GiesbrechtElectronics/GEQ1/GEQ1_AusfB_R3/BOM/GEQ1_AusfB_R3.xlsx

Sheet: Project
Capacitors
Order Qty. | Reference | Value | LibPart | Footprint | Mouser # | Mfr. # | Manufacturer | Customer # | Description | RoHS | Lifecycle | Order Qty. | Price (USD) | Ext.: (USD)
6 | C3, C6, C7, C8, C17, C18 | 100nF | device:C | Capacitors_SMD:C_0805 | 710-885012207098 | 885012207098 | Wurth Elektronik |  | Multilayer Ceramic Capacitors MLCC - SMD/SMT WCAP-CSGP 0.1uF 0805 10% 50V MLCC | RoHS Compliant |  | 6 | $0.10 | $0.60
6 | C21, C22, C25, C26, C27, C28 | 100pF | device:C | Capacitors_SMD:C_0805 | 710-885012007082 | 885012007082 | Wurth Elektronik |  | Multilayer Ceramic Capacitors MLCC - SMD/SMT WCAP-CSGP 100V 100pF 0805 5% | RoHS Compliant | New At Mouser | 6 | $0.10 | $0.60
4 | C14, C16, C19, C20 | 1.5uF | device:C | Capacitors_SMD:C_0805 | 810-C2012JB1E155K08C | C2012JB1E155K085AC | TDK |  | Multilayer Ceramic Capacitors MLCC - SMD/SMT 0805 25V 1.5uF JB 10% T: 0.85mm | RoHS Compliant |  | 4 | $0.27 | $1.08
2 | C1, C2 | 7.5nF | device:C | Capacitors_SMD:C_0805 | 81-GRM2195C1H752JA1D | GRM2195C1H752JA01D | Murata |  | Multilayer Ceramic Capacitors MLCC - SMD/SMT 0.0075uF 50Volts C0G 0.05 | RoHS Compliant |  | 2 | $0.34 | $0.68
2 | C4, C5 | 560pF | device:C | Capacitors_SMD:C_0805 | 77-VJ0805A561JXAAC | VJ0805A561JXAAC | Vishay |  | Multilayer Ceramic Capacitors MLCC - SMD/SMT 560pF 50volts C0G 5% | RoHS Compliant |  | 2 | $0.13 | $0.26
2 | C9, C11 | 22nF | device:C | Capacitors_SMD:C_0805 | 80-C0805C223K2RECAUT | C0805C223K2RECAUTO | KEMET |  | Multilayer Ceramic Capacitors MLCC - SMD/SMT 200V .022uF X7R 0805 10% AEC-Q200 | RoHS Compliant | New Product | 2 | $0.27 | $0.54
2 | C10, C12 | 220nF | device:C | Capacitors_SMD:C_0805 | 710-885012207074 | 885012207074 | Wurth Elektronik |  | Multilayer Ceramic Capacitors MLCC - SMD/SMT WCAP-CSGP 0.22uF 0805 10% 25V MLCC | RoHS Compliant |  | 2 | $0.11 | $0.22
2 | C13, C15 | 220uF | device:CP | Capacitors_SMD:CP_Elec_8x10 | 647-UWT1V221MNL1S | UWT1V221MNL1GS | Nichicon |  | Aluminum Electrolytic Capacitors - SMD 35volts 220uF 8x10 20% | RoHS Compliant |  | 2 | $0.44 | $0.88
2 | C23, C24 | 10nF | device:C | Capacitors_SMD:C_0805 | 710-885012207092 | 885012207092 | Wurth Elektronik |  | Multilayer Ceramic Capacitors MLCC - SMD/SMT WCAP-CSGP 0.01uF 0805 10% 50V MLCC | RoHS Compliant |  | 2 | $0.10 | $0.20
Resistors
Order Qty. | Reference | Value | LibPart | Footprint | Mouser # | Mfr. # | Manufacturer | Customer # | Description | RoHS | Lifecycle | Order Qty. | Price (USD) | Ext.: (USD)
12 | R3, R5, R10, R12, R14, R16, R21, R22, R34, R35, R36, R37 | 100K | device:R | Resistors_SMD:R_0805 | 652-CR0805FX-1003ELF | CR0805-FX-1003ELF | Bourns |  | Thick Film Resistors - SMD 100K 1% | RoHS Compliant By Exemption |  | 12 | $0.01 | $0.18
5 | R1, R11, R27, R32, R33 | 10K | device:R | Resistors_SMD:R_0805 | 652-CR0805FX-1002ELF | CR0805-FX-1002ELF | Bourns |  | Thick Film Resistors - SMD 10K 1% | RoHS Compliant By Exemption |  | 5 | $0.10 | $0.50
4 | R2, R4, R8, R9 | 49.9R | device:R | Resistors_SMD:R_0805 | 652-CR0805FX-49R9ELF | CR0805-FX-49R9ELF | Bourns |  | Thick Film Resistors - SMD 49.9ohm 1% | RoHS Compliant By Exemption |  | 4 | $0.10 | $0.40
4 | R13, R15, R19, R20 | 1.24K | device:R | Resistors_SMD:R_0805 | 603-AC0805FR-071K24L | AC0805FR-071K24L | Yageo |  | Thick Film Resistors - SMD AEC-Q200 | RoHS Compliant |  | 4 | $0.16 | $0.64
4 | R23, R24, R25, R26 | 249R | device:R | Resistors_SMD:R_0805 | 652-CR0805FX-2490ELF | CR0805-FX-2490ELF | Bourns |  | Thick Film Resistors - SMD 249ohm 1% | RoHS Compliant By Exemption |  | 4 | $0.10 | $0.40
3 | R6, R17, R18 | 49.9K | device:R | Resistors_SMD:R_0805 | 71-RCG080549K9FKEA | RCG080549K9FKEA | Vishay |  | Thick Film Resistors - SMD .125watt 49.9kohms 1% 0805 100ppm | RoHS Compliant |  | 3 | $0.10 | $0.30
3 | RV1, RV2, RV3 | 50K | device:POT_Dual_Separate | AlphaFootprints:POT_2GANG_RK12L | 688-RK12L123000E | RK12L123000E | ALPS |  | Potentiometers 12MM V/ADJ | RoHS Compliant |  | 3 | $0.92 | $2.76
2 | R28, R29 | 1K | device:R | Resistors_SMD:R_0805 | 652-CR0805FX-1001ELF | CR0805-FX-1001ELF | Bourns |  | Thick Film Resistors - SMD 1K 1% | RoHS Compliant By Exemption |  | 2 | $0.10 | $0.20
2 | R30, R31 | 2.49K | device:R | Resistors_SMD:R_0805 | 652-CR0805FX-2491ELF | CR0805-FX-2491ELF | Bourns |  | Thick Film Resistors - SMD 2.49K 1% | RoHS Compliant By Exemption |  | 2 | $0.10 | $0.20
1 | R7 | 2R | device:R | Resistors_SMD:R_0805 | 603-RC0805FR-072RL | RC0805FR-072RL | Yageo |  | Thick Film Resistors - SMD 2 OHM 1% | RoHS Compliant |  | 1 | $0.10 | $0.10
1 | RV4 | 20K | device:POT_Dual_Separate | AlphaFootprints:POT_2GANG_RK12L | 688-RK12L12C0A0A | RK12L12C0A0A | ALPS |  | Potentiometers 12MM V/ADJ | RoHS Compliant |  | 1 | $0.70 | $0.70
Transistors
Order Qty. | Reference | Value | LibPart | Footprint | Mouser # | Mfr. # | Manufacturer | Customer # | Description | RoHS | Lifecycle | Order Qty. | Price (USD) | Ext.: (USD)
2 | Q2, Q3 | DMP3098LQ-7 | device:Q_PMOS_GSD | TO_SOT_Packages_SMD:SOT-23 | 621-DMP3098LQ-7 | DMP3098LQ-7 | Diodes Incorporated |  | MOSFET MOSFETBVDSS: 25V-30V | RoHS Compliant | New At Mouser | 2 | $0.34 | $0.68
1 | Q1 | BC856 | device:Q_PNP_BEC | TO_SOT_Packages_SMD:SOT-23_Handsoldering | 863-BC856BLT1G | BC856BLT1G | ON Semiconductor |  | Bipolar Transistors - BJT 100mA 80V PNP | RoHS Compliant |  | 1 | $0.13 | $0.13
Electromechanical
Order Qty. | Reference | Value | LibPart | Footprint | Mouser # | Mfr. # | Manufacturer | Customer # | Description | RoHS | Lifecycle | Order Qty. | Price (USD) | Ext.: (USD)
2 | M1, M2 | SJ-43515TS | AlphaComponents:AUDIO-JACK-TRRS | AlphaFootprints:TRRS_SJ-43515TS | 490-SJ-43515TS | SJ-43515TS | CUI Inc. |  | Phone Connectors audio jack, 3.5 mm, rt, 4 conductor, through hole, 1 switch | RoHS Compliant |  | 2 | $1.04 | $2.08
1 | SW1 | 2M1-SP1-T1-B1-M2QE | GEQ1_AusfB_R3-cache:SW_SPST-RESCUE-GEQ1_AusfB_R1 | AlphaFootprints:2M1-SP1-TnBnM2 | 691-2M1-SP1-T1B1M2QE | 2M1-SP1-T1-B1-M2QE | Carling Technologies |  | Toggle Switches Toggle PC MNT ON -NONE -ON | RoHS Compliant |  | 1 | $2.32 | $2.32
1 | J1 | PJ-102A | conn:Barrel_Jack | AlphaFootprints:PJ_102A | 490-PJ-102A | PJ-102A | CUI Inc. | GP-DC PJ | DC Power Connectors Power Jacks | RoHS Compliant |  | 1 | $0.64 | $0.64
1 | BT1 | 9V | device:Battery | AlphaFootprints:2_Pin_Header | 534-81-8TB | 81-8 | Keystone Electronics |  | 9V Battery Snaps & Contacts SHIELDED 9 VOLT "T" Strap 8.0" L | RoHS Compliant |  | 1 | $0.49 | $0.49
1 | - | Knob-Large | - | - | 45KN013-GRX | 45KN013-GRX | Eagle Plastic Devices |  | Knobs & Dials BLACK 0.94"DX0.59"H | RoHS Compliant By Exemption |  | 1 | $1.14 | $1.14
Semis (Other)
Order Qty. | Reference | Value | LibPart | Footprint | Mouser # | Mfr. # | Manufacturer | Customer # | Description | RoHS | Lifecycle | Order Qty. | Price (USD) | Ext.: (USD)
6 | U1, U2, U3, U4, U5, U6 | LM833 | linear:LM7332 | AlphaFootprints:SOIC-8_Pin1Line | 511-LM833DT | LM833DT | STMicroelectronics |  | Audio Amplifiers Dual Low Noise | RoHS Compliant |  | 6 | $0.53 | $3.18
1 | D1 | BLUE | device:LED | AlphaFootprints:LED_1206_REV | 859-LTST-C230TBKT | LTST-C230TBKT | Lite-On |  | Standard LEDs - SMD Blue Clear 470nm | RoHS Compliant |  | 1 | $0.36 | $0.36
Inductors
Order Qty. | Reference | Value | LibPart | Footprint | Mouser # | Mfr. # | Manufacturer | Customer # | Description | RoHS | Lifecycle | Order Qty. | Price (USD) | Ext.: (USD)
2 | L1, L2 | MPZ2012S102JTD25 | device:Ferrite_Bead | Inductors_SMD:L_0805 | 810-MPZ2012S102JTD25 | MPZ2012S102JTD25 | TDK |  | Ferrite Beads 0805 1.5A 25% 0.15ohms AEC-Q200 | RoHS Compliant | New Product | 2 | $0.13 | $0.26

Sheet: Project (2)
Capacitors
Order Qty. | Reference | Value | LibPart | Footprint | Mouser # | Mfr. # | Manufacturer | Customer # | Description | RoHS | Lifecycle | Order Qty. | Price (USD) | Ext.: (USD)
6 | C3, C6, C7, C8, C17, C18 | 100nF | device:C | Capacitors_SMD:C_0805 | 710-885012207098 | 885012207098 | Wurth Elektronik |  | Multilayer Ceramic Capacitors MLCC - SMD/SMT WCAP-CSGP 0.1uF 0805 10% 50V MLCC | RoHS Compliant |  | 6 | $0.10 | $0.60
6 | C21, C22, C25, C26, C27, C28 | 100pF | device:C | Capacitors_SMD:C_0805 | 710-885012007082 | 885012007082 | Wurth Elektronik |  | Multilayer Ceramic Capacitors MLCC - SMD/SMT WCAP-CSGP 100V 100pF 0805 5% | RoHS Compliant | New At Mouser | 6 | $0.10 | $0.60
4 | C14, C16, C19, C20 | 1.5uF | device:C | Capacitors_SMD:C_0805 | 810-C2012JB1E155K08C | C2012JB1E155K085AC | TDK |  | Multilayer Ceramic Capacitors MLCC - SMD/SMT 0805 25V 1.5uF JB 10% T: 0.85mm | RoHS Compliant |  | 4 | $0.27 | $1.08
2 | C1, C2 | 7.5nF | device:C | Capacitors_SMD:C_0805 | 81-GRM2195C1H752JA1D | GRM2195C1H752JA01D | Murata |  | Multilayer Ceramic Capacitors MLCC - SMD/SMT 0.0075uF 50Volts C0G 0.05 | RoHS Compliant |  | 2 | $0.34 | $0.68
2 | C4, C5 | 560pF | device:C | Capacitors_SMD:C_0805 | 77-VJ0805A561JXAAC | VJ0805A561JXAAC | Vishay |  | Multilayer Ceramic Capacitors MLCC - SMD/SMT 560pF 50volts C0G 5% | RoHS Compliant |  | 2 | $0.13 | $0.26
2 | C9, C11 | 22nF | device:C | Capacitors_SMD:C_0805 | 80-C0805C223K2RECAUT | C0805C223K2RECAUTO | KEMET |  | Multilayer Ceramic Capacitors MLCC - SMD/SMT 200V .022uF X7R 0805 10% AEC-Q200 | RoHS Compliant | New Product | 2 | $0.27 | $0.54
2 | C10, C12 | 220nF | device:C | Capacitors_SMD:C_0805 | 710-885012207074 | 885012207074 | Wurth Elektronik |  | Multilayer Ceramic Capacitors MLCC - SMD/SMT WCAP-CSGP 0.22uF 0805 10% 25V MLCC | RoHS Compliant |  | 2 | $0.11 | $0.22
2 | C13, C15 | 220uF | device:CP | Capacitors_SMD:CP_Elec_8x10 | 647-UWT1V221MNL1S | UWT1V221MNL1GS | Nichicon |  | Aluminum Electrolytic Capacitors - SMD 35volts 220uF 8x10 20% | RoHS Compliant |  | 2 | $0.44 | $0.88
2 | C23, C24 | 10nF | device:C | Capacitors_SMD:C_0805 | 710-885012207092 | 885012207092 | Wurth Elektronik |  | Multilayer Ceramic Capacitors MLCC - SMD/SMT WCAP-CSGP 0.01uF 0805 10% 50V MLCC | RoHS Compliant |  | 2 | $0.10 | $0.20
Resistors
Order Qty. | Reference | Value | LibPart | Footprint | Mouser # | Mfr. # | Manufacturer | Customer # | Description | RoHS | Lifecycle | Order Qty. | Price (USD) | Ext.: (USD)
12 | R3, R5, R10, R12, R14, R16, R21, R22, R34, R35, R36, R37 | 100K | device:R | Resistors_SMD:R_0805 | 652-CR0805FX-1003ELF | CR0805-FX-1003ELF | Bourns |  | Thick Film Resistors - SMD 100K 1% | RoHS Compliant By Exemption |  | 12 | $0.01 | $0.18
5 | R1, R11, R27, R32, R33 | 10K | device:R | Resistors_SMD:R_0805 | 652-CR0805FX-1002ELF | CR0805-FX-1002ELF | Bourns |  | Thick Film Resistors - SMD 10K 1% | RoHS Compliant By Exemption |  | 5 | $0.10 | $0.50
4 | R2, R4, R8, R9 | 49.9R | device:R | Resistors_SMD:R_0805 | 652-CR0805FX-49R9ELF | CR0805-FX-49R9ELF | Bourns |  | Thick Film Resistors - SMD 49.9ohm 1% | RoHS Compliant By Exemption |  | 4 | $0.10 | $0.40
4 | R13, R15, R19, R20 | 1.24K | device:R | Resistors_SMD:R_0805 | 603-AC0805FR-071K24L | AC0805FR-071K24L | Yageo |  | Thick Film Resistors - SMD AEC-Q200 | RoHS Compliant |  | 4 | $0.16 | $0.64
4 | R23, R24, R25, R26 | 249R | device:R | Resistors_SMD:R_0805 | 652-CR0805FX-2490ELF | CR0805-FX-2490ELF | Bourns |  | Thick Film Resistors - SMD 249ohm 1% | RoHS Compliant By Exemption |  | 4 | $0.10 | $0.40
3 | R6, R17, R18 | 49.9K | device:R | Resistors_SMD:R_0805 | 71-RCG080549K9FKEA | RCG080549K9FKEA | Vishay |  | Thick Film Resistors - SMD .125watt 49.9kohms 1% 0805 100ppm | RoHS Compliant |  | 3 | $0.10 | $0.30
3 | RV1, RV2, RV3 | 50K | device:POT_Dual_Separate | AlphaFootprints:POT_2GANG_RK12L | 688-RK12L123000E | RK12L123000E | ALPS |  | Potentiometers 12MM V/ADJ | RoHS Compliant |  | 3 | $0.92 | $2.76
2 | R28, R29 | 1K | device:R | Resistors_SMD:R_0805 | 652-CR0805FX-1001ELF | CR0805-FX-1001ELF | Bourns |  | Thick Film Resistors - SMD 1K 1% | RoHS Compliant By Exemption |  | 2 | $0.10 | $0.20
2 | R30, R31 | 2.49K | device:R | Resistors_SMD:R_0805 | 652-CR0805FX-2491ELF | CR0805-FX-2491ELF | Bourns |  | Thick Film Resistors - SMD 2.49K 1% | RoHS Compliant By Exemption |  | 2 | $0.10 | $0.20
1 | R7 | 2R | device:R | Resistors_SMD:R_0805 | 603-RC0805FR-072RL | RC0805FR-072RL | Yageo |  | Thick Film Resistors - SMD 2 OHM 1% | RoHS Compliant |  | 1 | $0.10 | $0.10
1 | RV4 | 20K | device:POT_Dual_Separate | AlphaFootprints:POT_2GANG_RK12L | 688-RK12L12C0A0A | RK12L12C0A0A | ALPS |  | Potentiometers 12MM V/ADJ | RoHS Compliant |  | 1 | $0.70 | $0.70
Transistors
Order Qty. | Reference | Value | LibPart | Footprint | Mouser # | Mfr. # | Manufacturer | Customer # | Description | RoHS | Lifecycle | Order Qty. | Price (USD) | Ext.: (USD)
2 | Q2, Q3 | DMP3098LQ-7 | device:Q_PMOS_GSD | TO_SOT_Packages_SMD:SOT-23 | 621-DMP3098LQ-7 | DMP3098LQ-7 | Diodes Incorporated |  | MOSFET MOSFETBVDSS: 25V-30V | RoHS Compliant | New At Mouser | 2 | $0.34 | $0.68
1 | Q1 | BC856 | device:Q_PNP_BEC | TO_SOT_Packages_SMD:SOT-23_Handsoldering | 863-BC856BLT1G | BC856BLT1G | ON Semiconductor |  | Bipolar Transistors - BJT 100mA 80V PNP | RoHS Compliant |  | 1 | $0.13 | $0.13
Electromechanical
Order Qty. | Reference | Value | LibPart | Footprint | Mouser # | Mfr. # | Manufacturer | Customer # | Description | RoHS | Lifecycle | Order Qty. | Price (USD) | Ext.: (USD)
2 | M1, M2 | SJ-43515TS | AlphaComponents:AUDIO-JACK-TRRS | AlphaFootprints:TRRS_SJ-43515TS | 490-SJ-43515TS | SJ-43515TS | CUI Inc. |  | Phone Connectors audio jack, 3.5 mm, rt, 4 conductor, through hole, 1 switch | RoHS Compliant |  | 2 | $1.04 | $2.08
1 | SW1 | 2M1-SP1-T1-B1-M2QE | GEQ1_AusfB_R3-cache:SW_SPST-RESCUE-GEQ1_AusfB_R1 | AlphaFootprints:2M1-SP1-TnBnM2 | 691-2M1-SP1-T1B1M2QE | 2M1-SP1-T1-B1-M2QE | Carling Technologies |  | Toggle Switches Toggle PC MNT ON -NONE -ON | RoHS Compliant |  | 1 | $2.32 | $2.32
1 | J1 | PJ-102A | conn:Barrel_Jack | AlphaFootprints:PJ_102A | 490-PJ-102A | PJ-102A | CUI Inc. | GP-DC PJ | DC Power Connectors Power Jacks | RoHS Compliant |  | 1 | $0.64 | $0.64
1 | BT1 | 9V | device:Battery | AlphaFootprints:2_Pin_Header | 534-81-8TB | 81-8 | Keystone Electronics |  | 9V Battery Snaps & Contacts SHIELDED 9 VOLT "T" Strap 8.0" L | RoHS Compliant |  | 1 | $0.49 | $0.49
1 | - | Knob-Large | - | - | 45KN013-GRX | 45KN013-GRX | Eagle Plastic Devices |  | Knobs & Dials BLACK 0.94"DX0.59"H | RoHS Compliant By Exemption |  | 1 | $1.14 | $1.14
Semis (Other)
Order Qty. | Reference | Value | LibPart | Footprint | Mouser # | Mfr. # | Manufacturer | Customer # | Description | RoHS | Lifecycle | Order Qty. | Price (USD) | Ext.: (USD)
6 | U1, U2, U3, U4, U5, U6 | LM833 | linear:LM7332 | AlphaFootprints:SOIC-8_Pin1Line | 511-LM833DT | LM833DT | STMicroelectronics |  | Audio Amplifiers Dual Low Noise | RoHS Compliant |  | 6 | $0.53 | $3.18
1 | D1 | BLUE | device:LED | AlphaFootprints:LED_1206_REV | 859-LTST-C230TBKT | LTST-C230TBKT | Lite-On |  | Standard LEDs - SMD Blue Clear 470nm | RoHS Compliant |  | 1 | $0.36 | $0.36
Inductors
Order Qty. | Reference | Value | LibPart | Footprint | Mouser # | Mfr. # | Manufacturer | Customer # | Description | RoHS | Lifecycle | Order Qty. | Price (USD) | Ext.: (USD)
2 | L1, L2 | MPZ2012S102JTD25 | device:Ferrite_Bead | Inductors_SMD:L_0805 | 810-MPZ2012S102JTD25 | MPZ2012S102JTD25 | TDK |  | Ferrite Beads 0805 1.5A 25% 0.15ohms AEC-Q200 | RoHS Compliant | New Product | 2 | $0.13 | $0.26
