GiesbrechtElectronics/GEQ1/GEQ1_AusfB_R3/Products/GEQ1_AusfB_R3.pdf

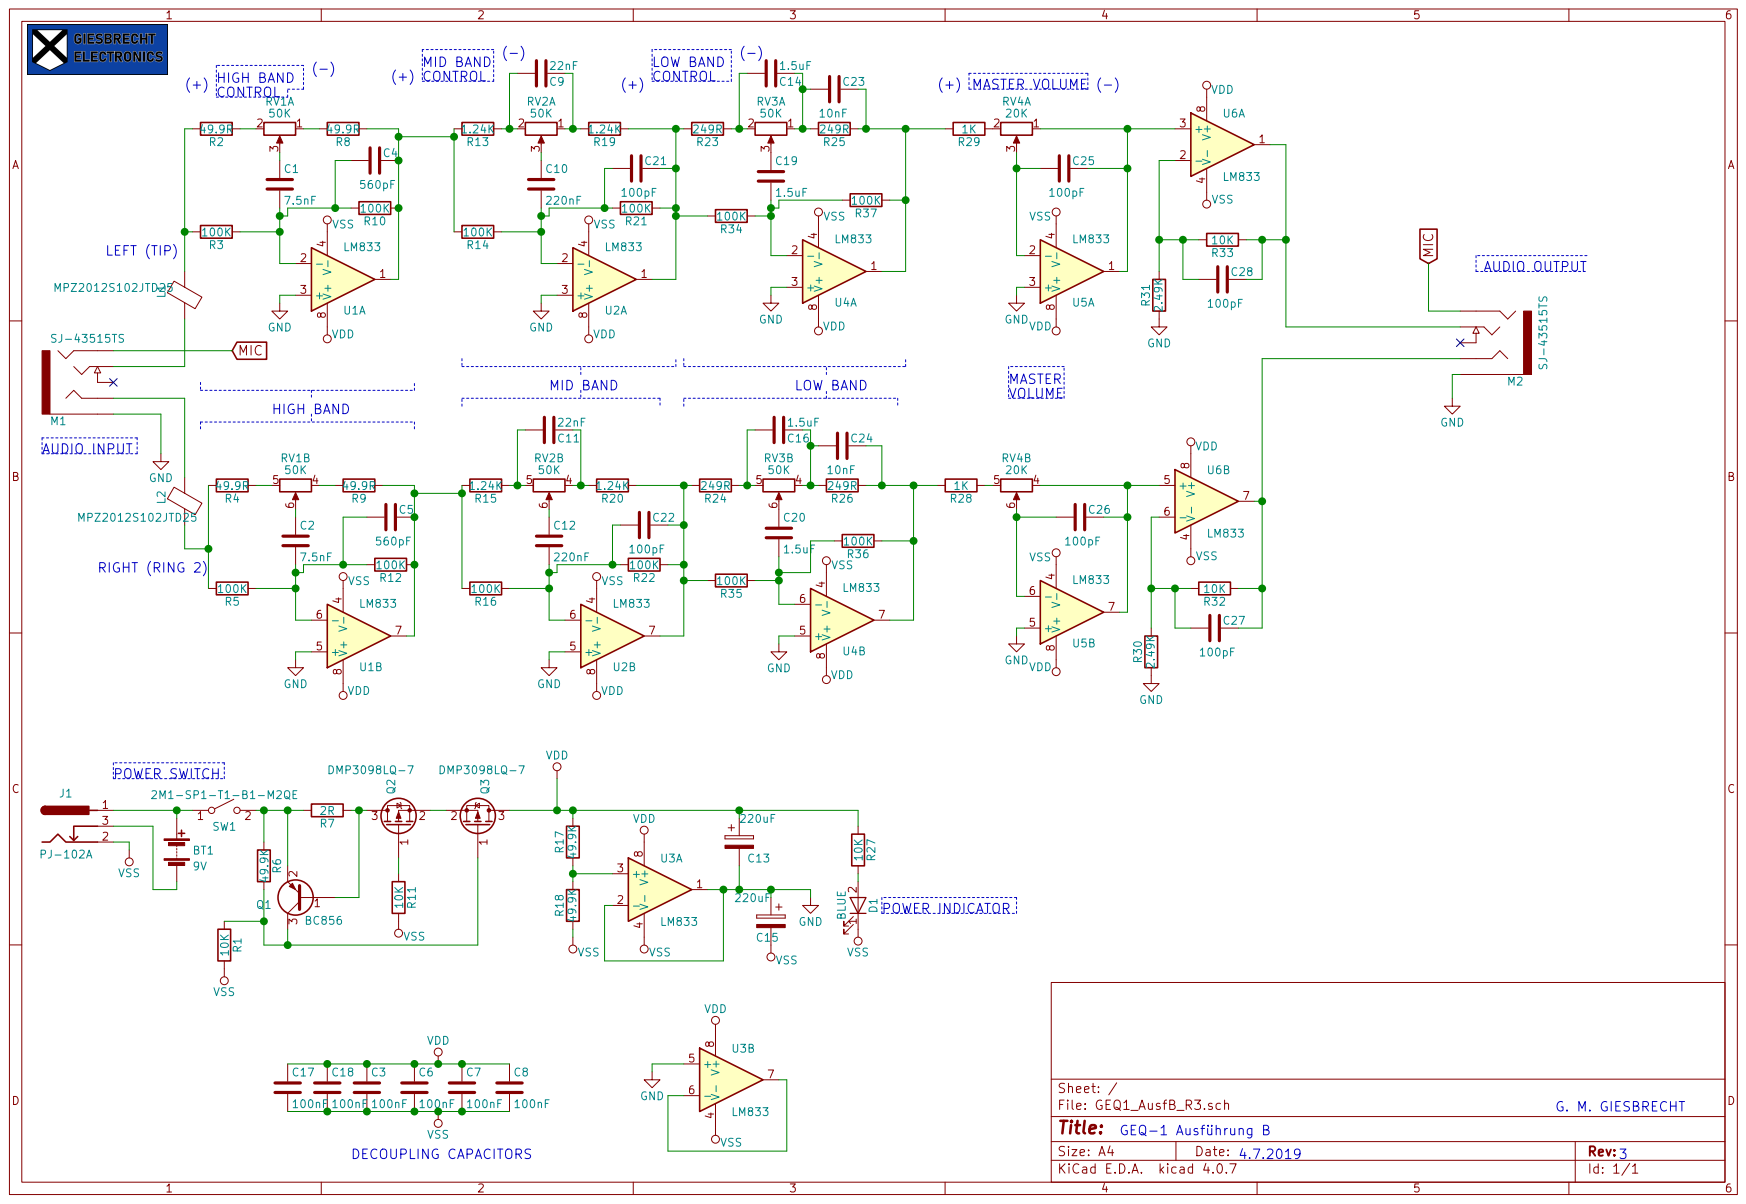
[picture p1: page 1]
