GiesbrechtElectronics/GEQ1/GEQ1_AusfB_R3/GEQ1_AusfB_R3.kicad_pcb

## KiCad design GEQ1_AusfB_R3/GEQ1_AusfB_R3.kicad_pcb (2019-09-10)

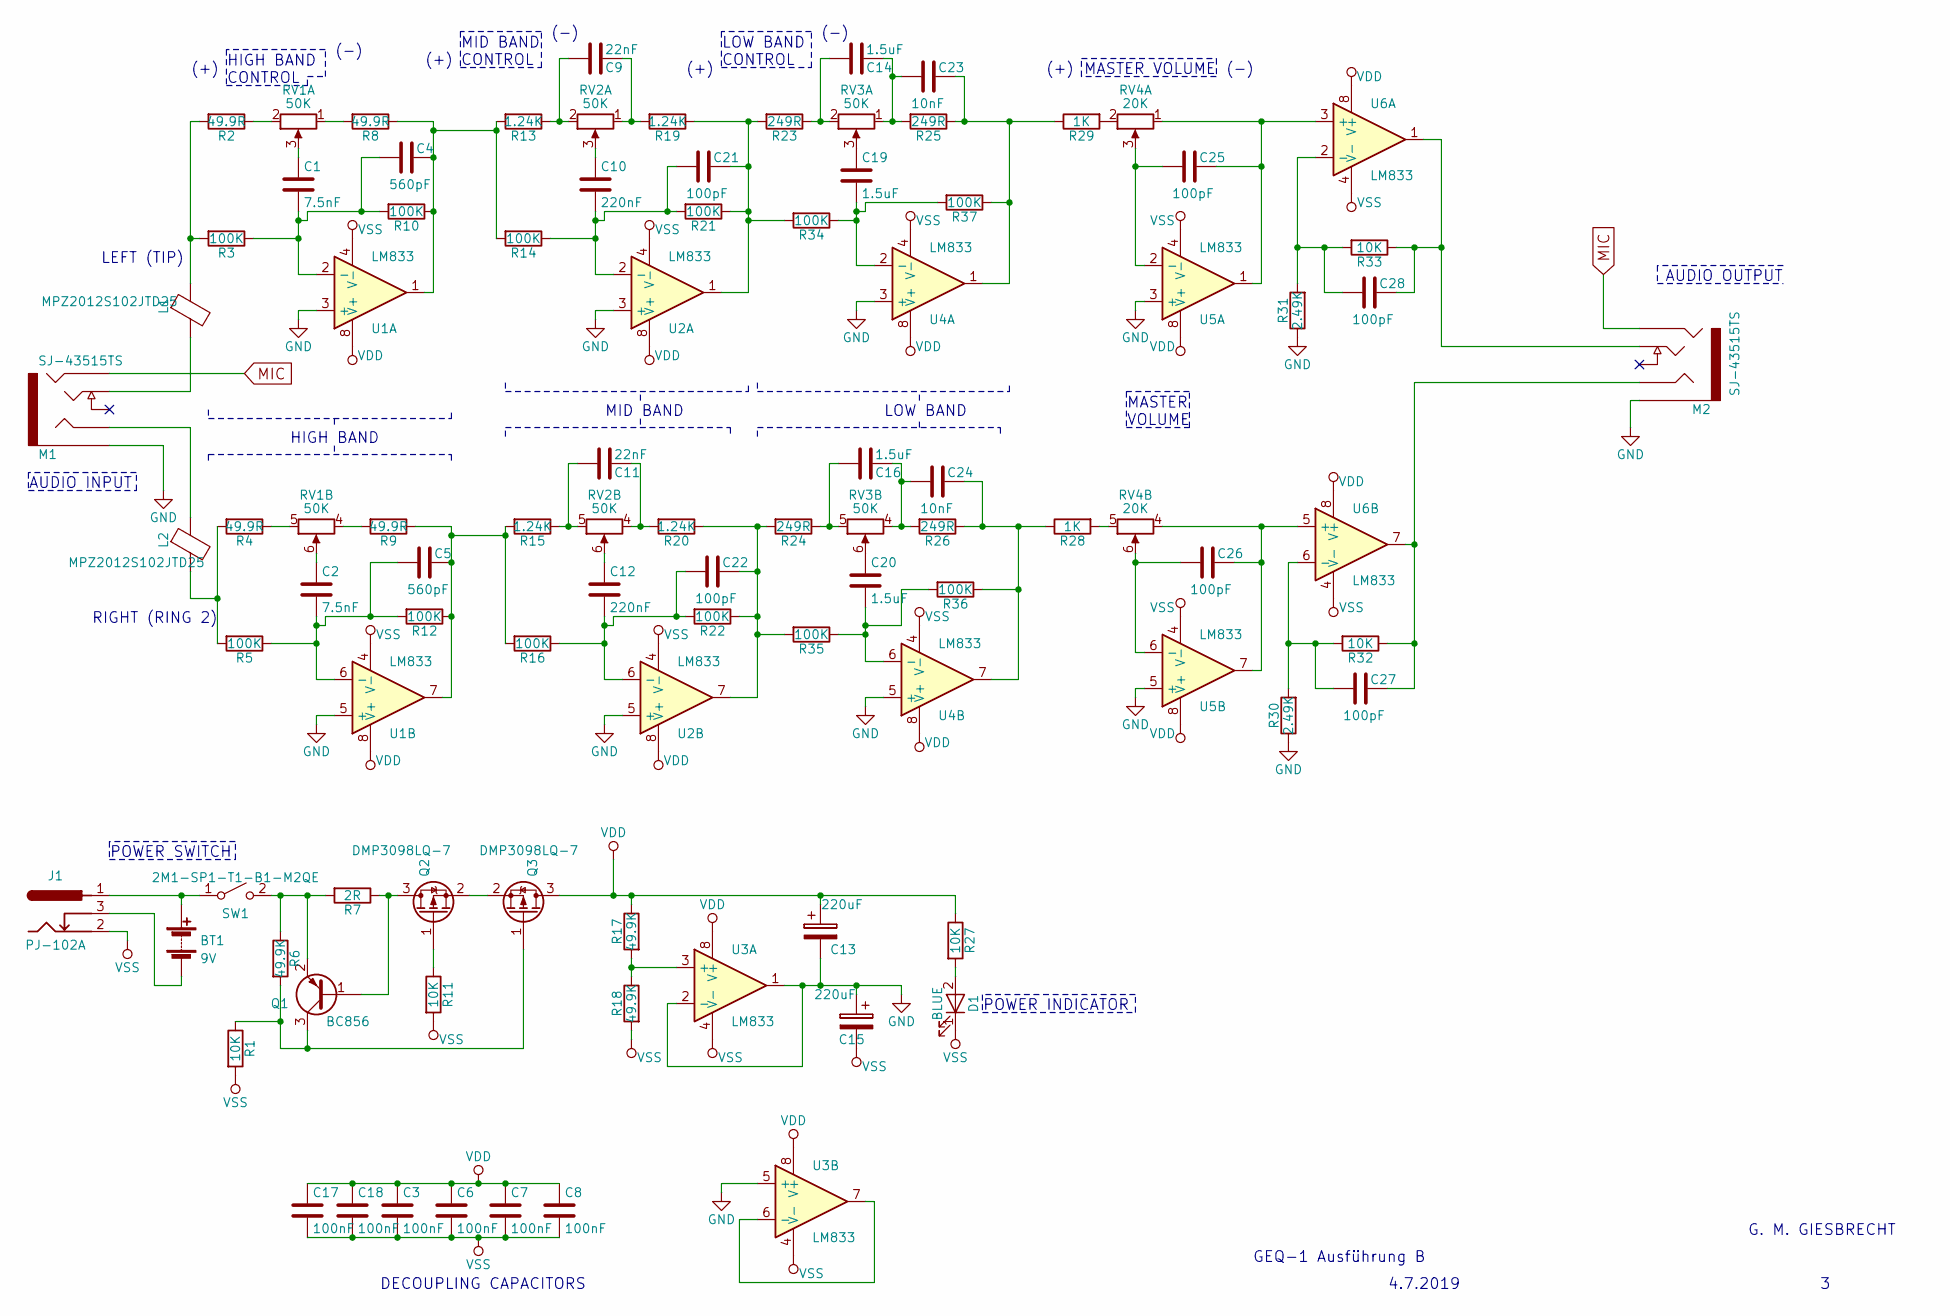
[picture p2: schematic GEQ1_AusfB_R3.sch]

Parts:
BT1: 9V; 2_Pin_Header
C1, C2: 7.5nF; C_0805
C3, C6, C7, C8, C17, C18: 100nF; C_0805
C4, C5: 560pF; C_0805
C9, C11: 22nF; C_0805
C10, C12: 220nF; C_0805
C13, C15: 220uF; CP_Elec_8x10
C14, C16, C19, C20: 1.5uF; C_0805
C21, C22, C25, C26, C27, C28: 100pF; C_0805
C23, C24: 10nF; C_0805
D1: BLUE; LED_1206_REV
J1: PJ-102A; PJ_102A
L1, L2: MPZ2012S102JTD25; L_0805
M1, M2: SJ-43515TS; TRRS_SJ-43515TS
Q1: BC856; SOT-23_Handsoldering
Q2, Q3: DMP3098LQ-7; SOT-23
R1, R11, R27, R32, R33: 10K; R_0805
R2, R4, R8, R9: 49.9R; R_0805
R3, R5, R10, R12, R14, R16, R21, R22, R34, R35, R36, R37: 100K; R_0805
R6, R17, R18: 49.9K; R_0805
R7: 2R; R_0805
R13, R15, R19, R20: 1.24K; R_0805
R23, R24, R25, R26: 249R; R_0805
R28, R29: 1K; R_0805
R30, R31: 2.49K; R_0805
RV1, RV2, RV3: 50K; POT_2GANG_RK12L
RV4: 20K; POT_2GANG_RK12L
SW1: 2M1-SP1-T1-B1-M2QE; 2M1-SP1-TnBnM2
U1, U2, U3, U4, U5, U6: LM833; SOIC-8_Pin1Line

Connections:
GND: C13.2, C15.1, M1.1 (SLEEVE), M2.1 (SLEEVE), R30.1, R31.1, U1.3 (+), U1.5 (+), U2.3 (+), U2.5 (+), U3.1, U3.2 (-), U3.5 (+), U4.3 (+), U4.5 (+), U5.3 (+), U5.5 (+)
MIC: M1.4 (RING2), M2.4 (RING2)
unnamed: BT1.1 (+), J1.1, SW1.1 (A)
unnamed: BT1.2 (-), J1.3
unnamed: C1.1, RV1.3 (6)
unnamed: C1.2, C4.2, R3.1, R10.2, U1.2 (-)
unnamed: C2.1, RV1.6
unnamed: C2.2, C5.2, R5.1, R12.2, U1.6 (-)
unnamed: C4.1, R8.1, R10.1, R13.2, R14.2, U1.1
unnamed: C5.1, R9.1, R12.1, R15.2, R16.2, U1.7
unnamed: C9.1, R19.2, RV2.1 (4)
unnamed: C9.2, R13.1, RV2.2 (5)
unnamed: C10.1, RV2.3 (6)
unnamed: C10.2, C21.2, R14.1, R21.2, U2.2 (-)
unnamed: C11.1, R20.2, RV2.4
unnamed: C11.2, R15.1, RV2.5
unnamed: C12.1, RV2.6
unnamed: C12.2, C22.2, R16.1, R22.2, U2.6 (-)
unnamed: C14.1, C23.2, R25.2, RV3.1 (4)
unnamed: C14.2, R23.1, RV3.2 (5)
unnamed: C16.1, C24.2, R26.2, RV3.4
unnamed: C16.2, R24.1, RV3.5
unnamed: C19.1, RV3.3 (6)
unnamed: C19.2, R34.1, R37.2, U4.2 (-)
unnamed: C20.1, RV3.6
unnamed: C20.2, R35.1, R36.2, U4.6 (-)
unnamed: C21.1, R19.1, R21.1, R23.2, R34.2, U2.1
unnamed: C22.1, R20.1, R22.1, R24.2, R35.2, U2.7
unnamed: C23.1, R25.1, R29.1, R37.1, U4.1
unnamed: C24.1, R26.1, R28.1, R36.1, U4.7
unnamed: C25.1, RV4.1 (4), U5.1, U6.3 (+)
unnamed: C25.2, RV4.3 (6), U5.2 (-)
unnamed: C26.1, RV4.4, U5.7, U6.5 (+)
unnamed: C26.2, RV4.6, U5.6 (-)
unnamed: C27.1, M2.3 (RING1), R32.1, U6.7
unnamed: C27.2, R30.2, R32.2, U6.6 (-)
unnamed: C28.1, M2.2 (TIP), R33.1, U6.1
unnamed: C28.2, R31.2, R33.2, U6.2 (-)
unnamed: D1.2 (A), R27.2
unnamed: L1.1, R2.2, R3.2
unnamed: L1.2, M1.2 (TIP)
unnamed: L2.1, M1.3 (RING1)
unnamed: L2.2, R4.2, R5.2
unnamed: Q1.1 (B), Q2.3 (D), R7.1
unnamed: Q1.2 (E), R6.1, R7.2, SW1.2 (B)
unnamed: Q1.3 (C), Q3.1 (G), R1.1, R6.2
unnamed: Q2.1 (G), R11.1
unnamed: Q2.2 (S), Q3.2 (S)
unnamed: R2.1, RV1.2 (5)
unnamed: R4.1, RV1.5
unnamed: R8.2, RV1.1 (4)
unnamed: R9.2, RV1.4
unnamed: R17.2, R18.1, U3.3 (+)
unnamed: R28.2, RV4.5
unnamed: R29.2, RV4.2 (5)
unnamed: U3.6 (-), U3.7
VDD: C3.1, C6.1, C7.1, C8.1, C13.1, C17.1, C18.1, Q3.3 (D), R17.1, R27.1, U1.8 (V+), U2.8 (V+), U3.8 (V+), U4.8 (V+), U5.8 (V+), U6.8 (V+)
VSS: C3.2, C6.2, C7.2, C8.2, C15.2, C17.2, C18.2, D1.1 (K), J1.2, R1.2, R11.2, R18.2, U1.4 (V-), U2.4 (V-), U3.4 (V-), U4.4 (V-), U5.4 (V-), U6.4 (V-)

Notes on the sheet:
LEFT (TIP)
RIGHT (RING 2)
LOW BAND
MID BAND
HIGH BAND
GEQ-1 Ausführung B
4.7.2019
G. M. GIESBRECHT
POWER INDICATOR
MASTER VOLUME
MID BAND CONTROL
LOW BAND CONTROL
HIGH BAND CONTROL
(-)
(+)
POWER SWITCH
AUDIO INPUT
AUDIO OUTPUT
DECOUPLING CAPACITORS
MASTER VOLUME

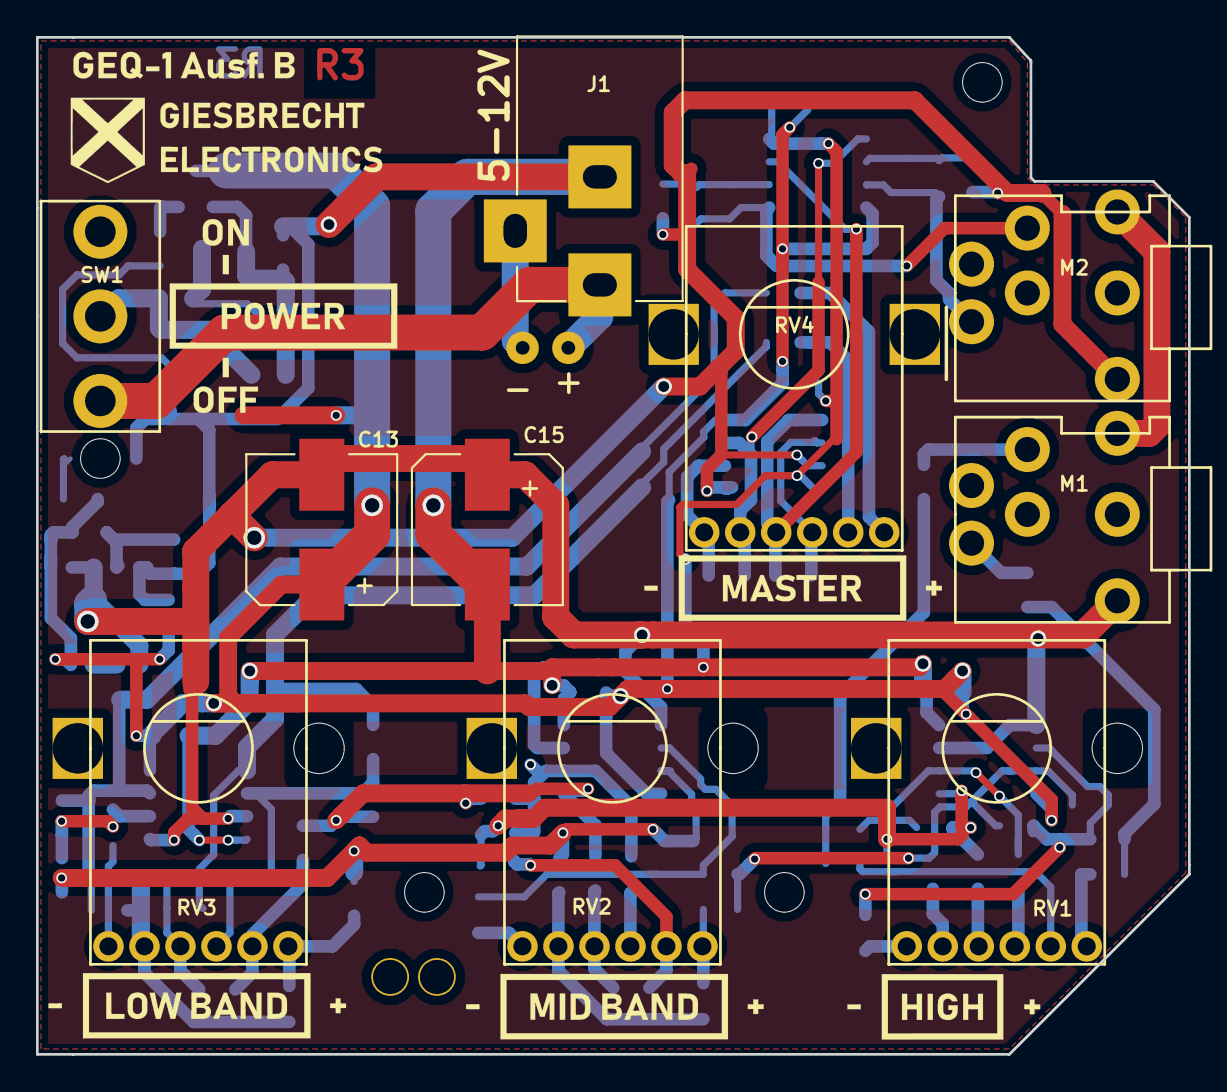
[picture p3: board GEQ1_AusfB_R3.kicad_pcb from above]

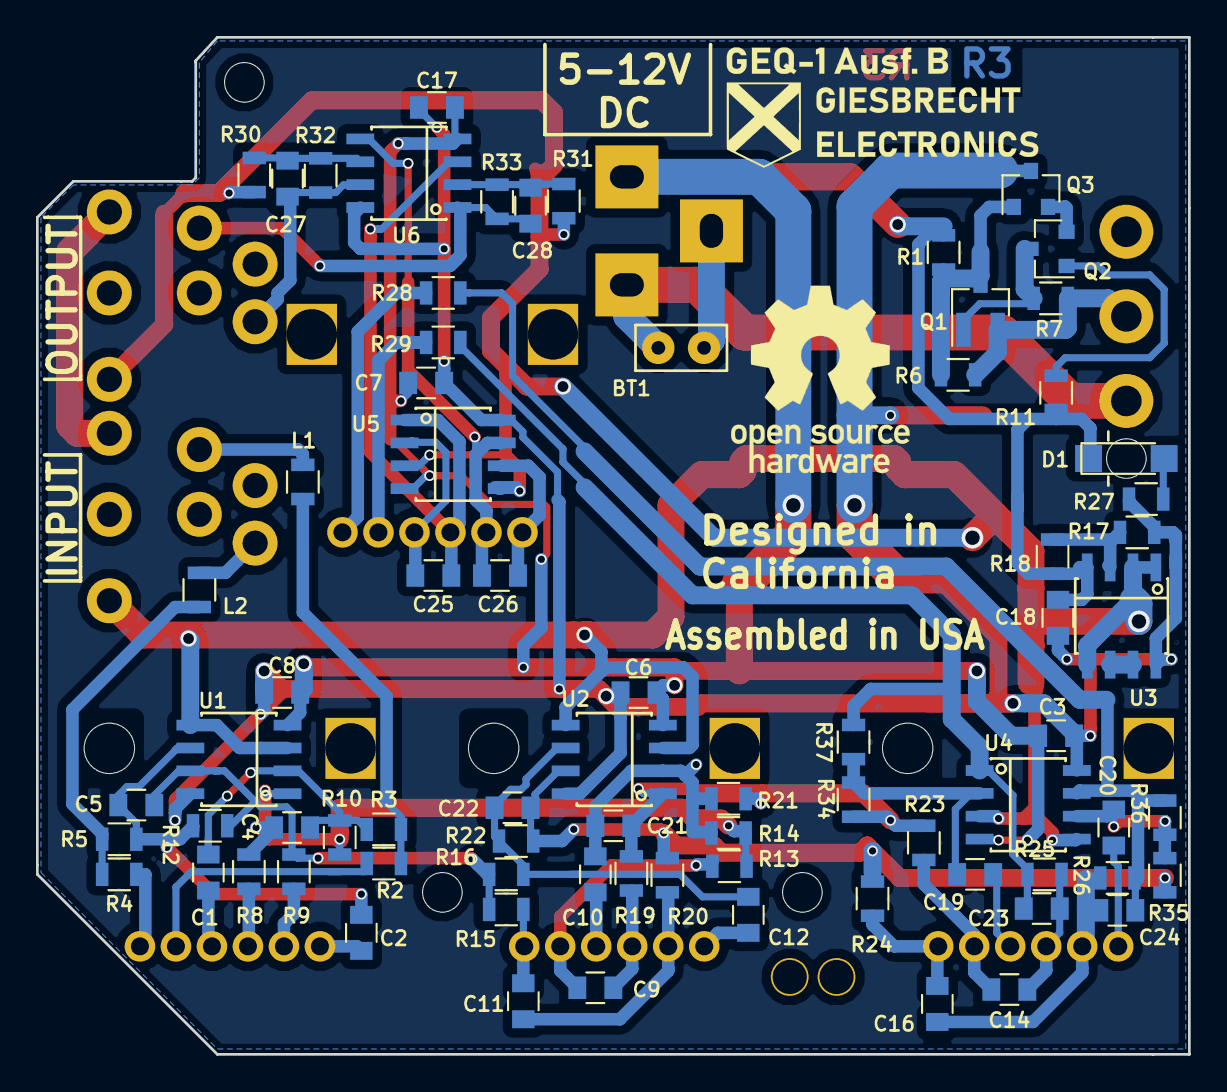
[picture p4: board GEQ1_AusfB_R3.kicad_pcb from below]

Board: 2 copper layers, 64.0 x 56.5 mm, 86 parts (76 on the bottom side), 58 nets.
